taoynkkx/LINDIY/README.md

# LINDIY
串口转隔离LIN总线

最近重心转移，请参见STM32F0_Platform项目。
