taoynkkx/LINDIY/05_Software/01_MC/src/bsp/README.md

板卡支持包 Board Support Package

主要是对于板卡级别的软件抽象。
