taoynkkx/LINDIY/05_Software/01_MC/src/README.md

源代码目录

app: 应用层
bsp: 板卡支持包
cfg: 配置和集成
lib: 通用软件库
msp: 芯片支持包
