taoynkkx/LINDIY/05_Software/01_MC/src/msp/README.md

单片机支持包 Micro Support Package

单片机级别的软件抽象。
