taoynkkx/LINDIY/04_Hardware/03_AltiumDesigner/LINDIY_Proj_v1.02.pdf

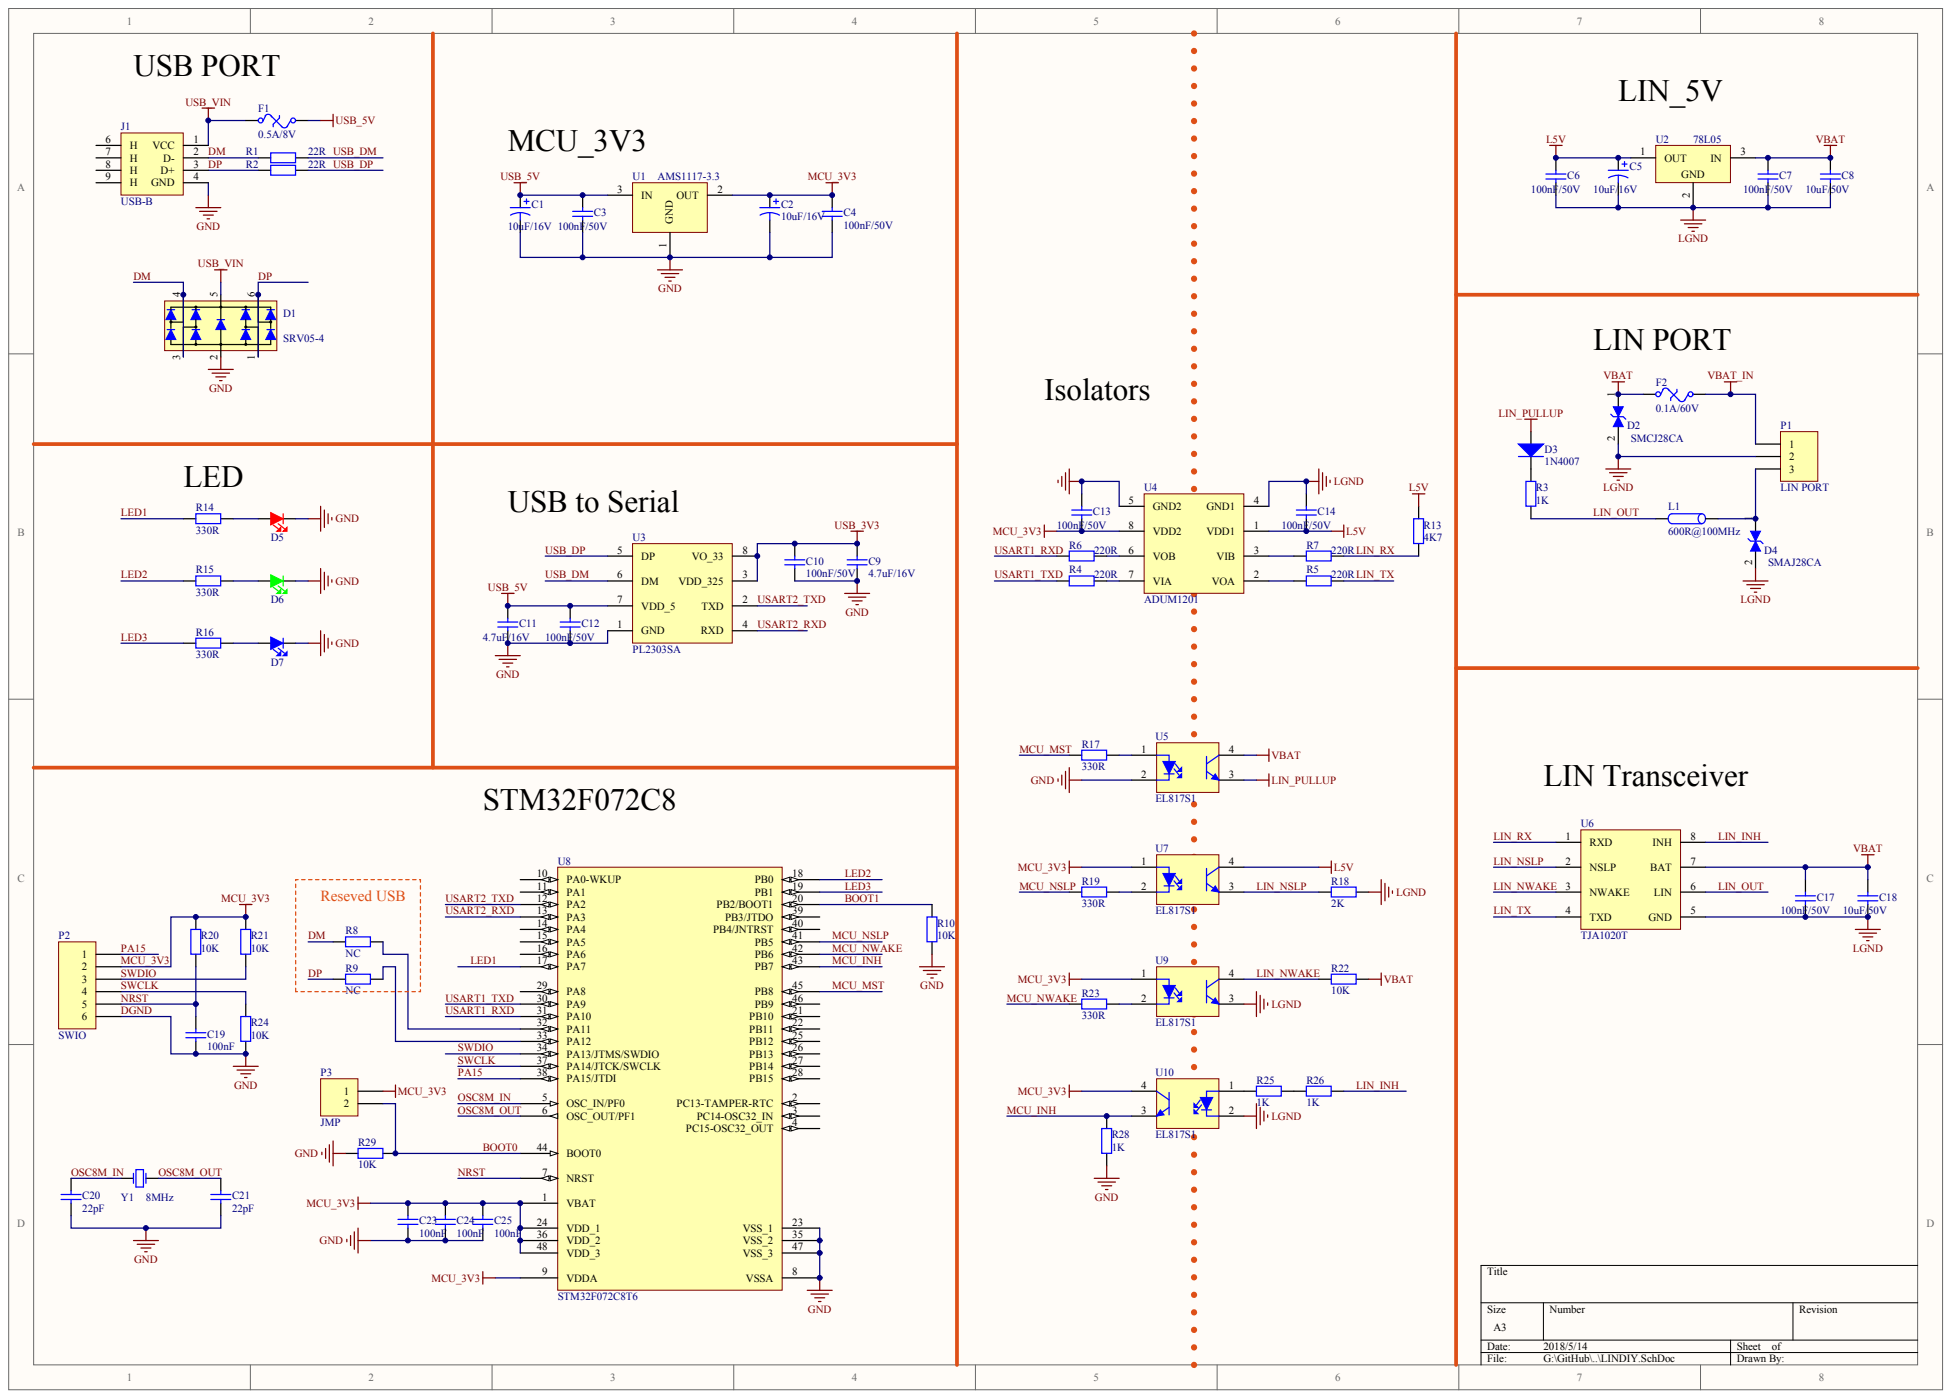
[picture p3: page 1]

NRST | | PA9 30
DGND | USART1_RXD | PA10 31

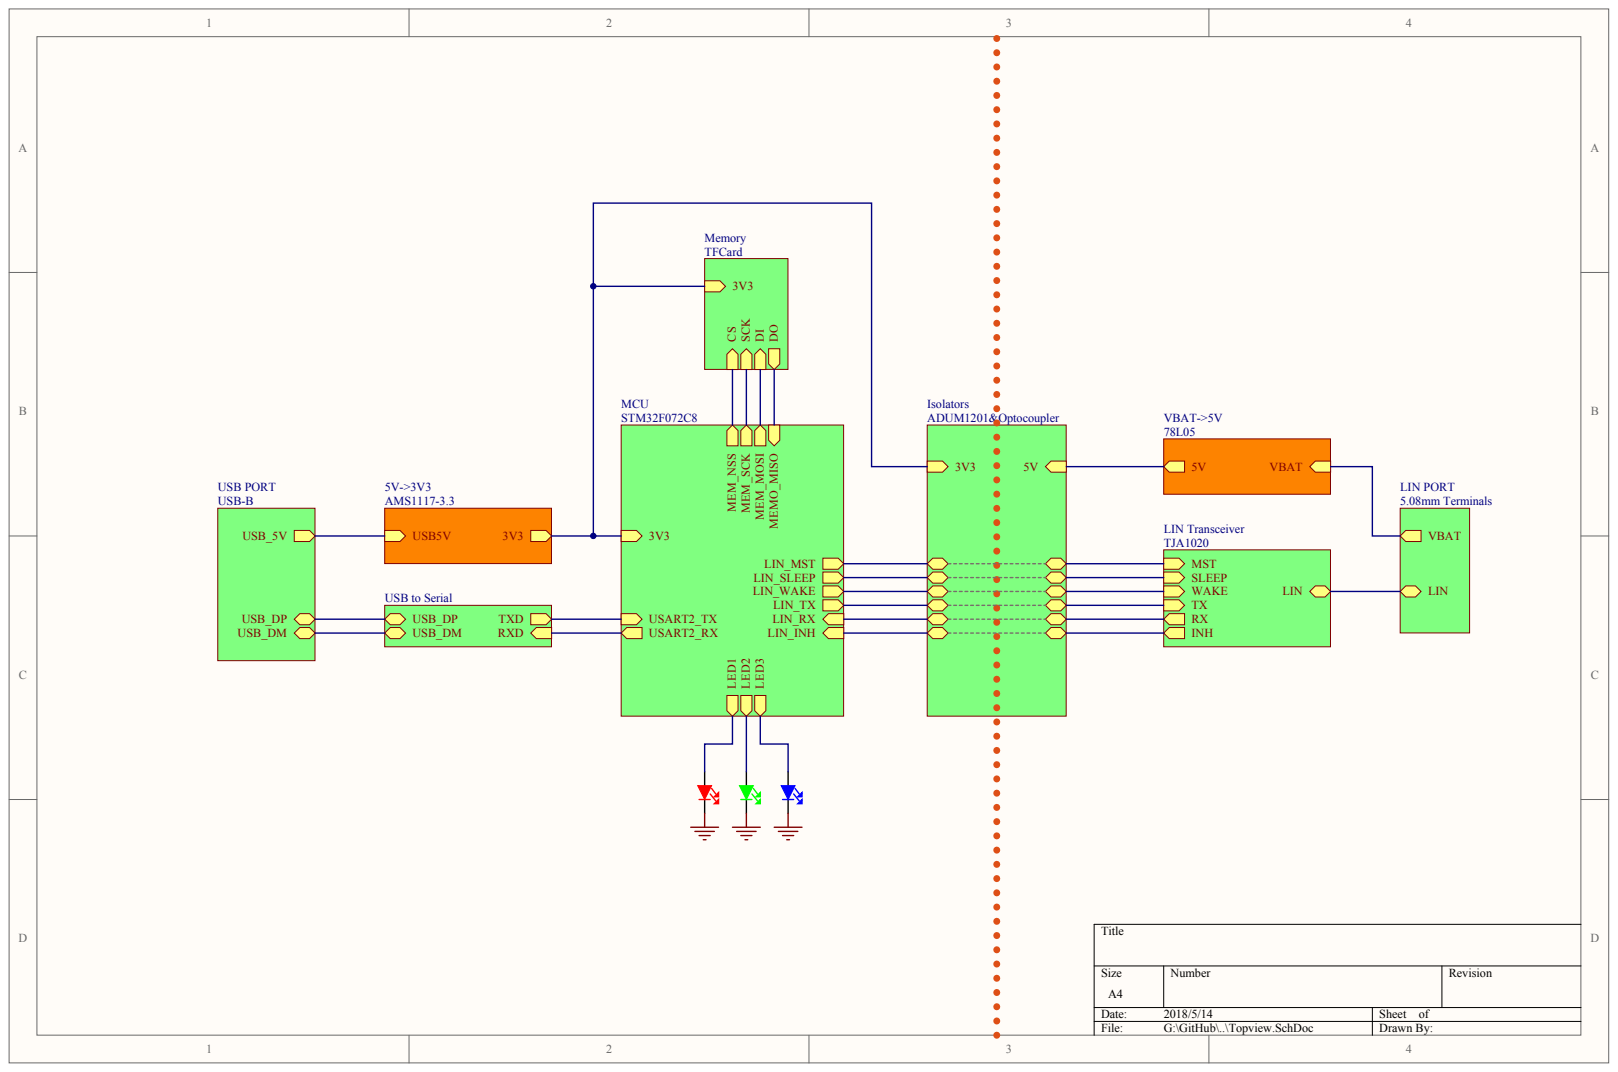
[picture p4: page 2]

LIN_SLEEP LIN_WAKE LIN_TX LIN_RX LIN_INH

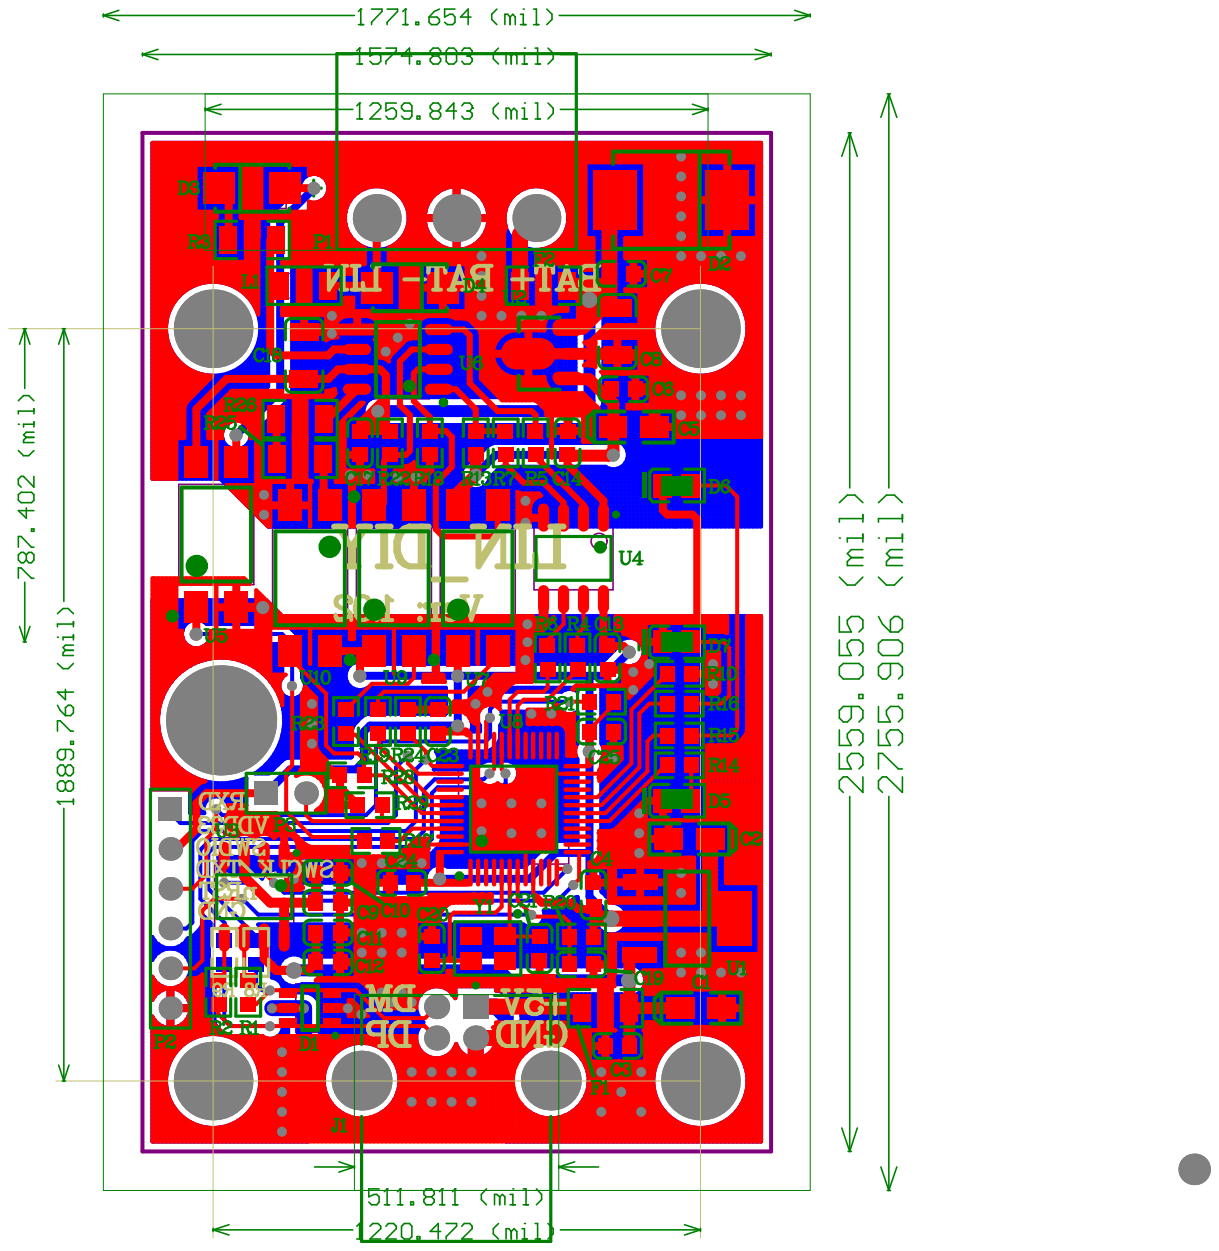
[picture p5: page 3]

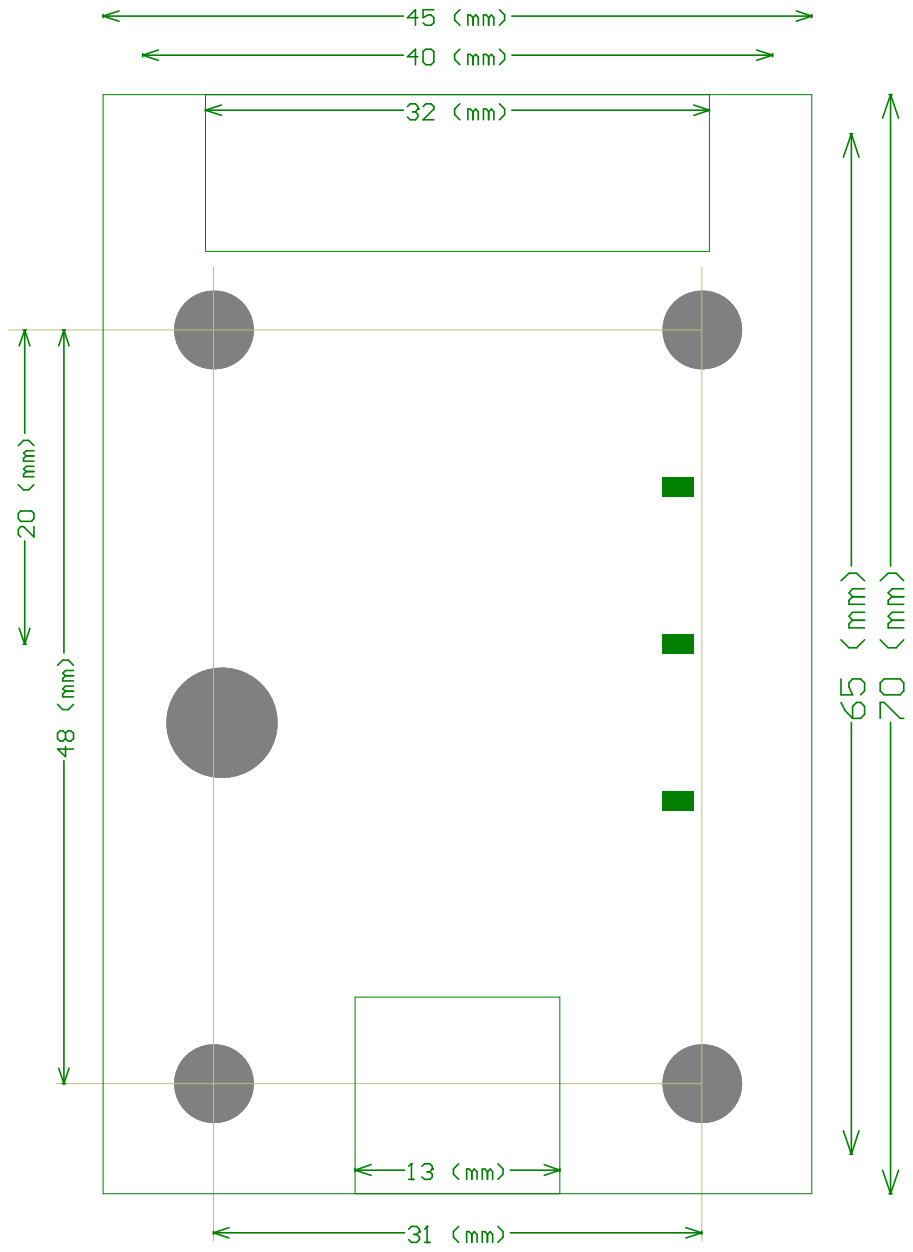
[picture p6: page 4]
