taoynkkx/LINDIY/(list of files, drawings)

Other design files:
04_Hardware/03_AltiumDesigner/LINDIY.PcbDoc
04_Hardware/03_AltiumDesigner/LINDIY.SchDoc
04_Hardware/03_AltiumDesigner/LINDIY_Proj.PrjPCB
04_Hardware/03_AltiumDesigner/outline.PcbDoc
04_Hardware/03_AltiumDesigner/Topview.SchDoc
