taoynkkx/LINDIY/(commit log)

2018-05-10 创建初始目录结构
2018-05-11 chaled
    提交初次版本准备打样的HardWare文件。
    [LINDIY.PcbDoc, LINDIY.SchDoc, LINDIY_Proj.PrjPCB, Topview.SchDoc, outline.PcbDoc]
2018-05-11 添加原理图的PDF文件
2018-05-12 HardWare V1.01
    #4 #5 #6 #7 以完成问题的修改。详细修改信息可以参考04_Hardware\03_AltiumDesigner\README.md
    [LINDIY.PcbDoc, LINDIY.SchDoc]
2018-05-12 add pdf file
    增加硬件pdf版本文件
2018-05-14 update v1.02
    #7 已经按需求修改，并同时更新版本为V1.02。具体更改信息可参考：LINDIY\04_Hardware\03_AltiumDesigner\README.md
    [LINDIY.PcbDoc, LINDIY.SchDoc]
2018-05-14 #8 创建软件目录结构
2018-05-14 #8 添加STM32F0官方库文件
2018-05-14 #8 添加KEIL项目文件
2018-05-14 #8 添加.gitignore
2018-05-14 #8 忽略bak文件
2018-05-23 #9 添加任务调度器模块
